aaronluebbert/ChessLink/pcb/Microcontroller Lab Summer 2026/ESP+Power_Only/ESP+Power_Only.kicad_pcb

## KiCad design pcb/Microcontroller Lab Summer 2026/ESP+Power_Only/ESP+Power_Only.kicad_pcb (2026-08-12)

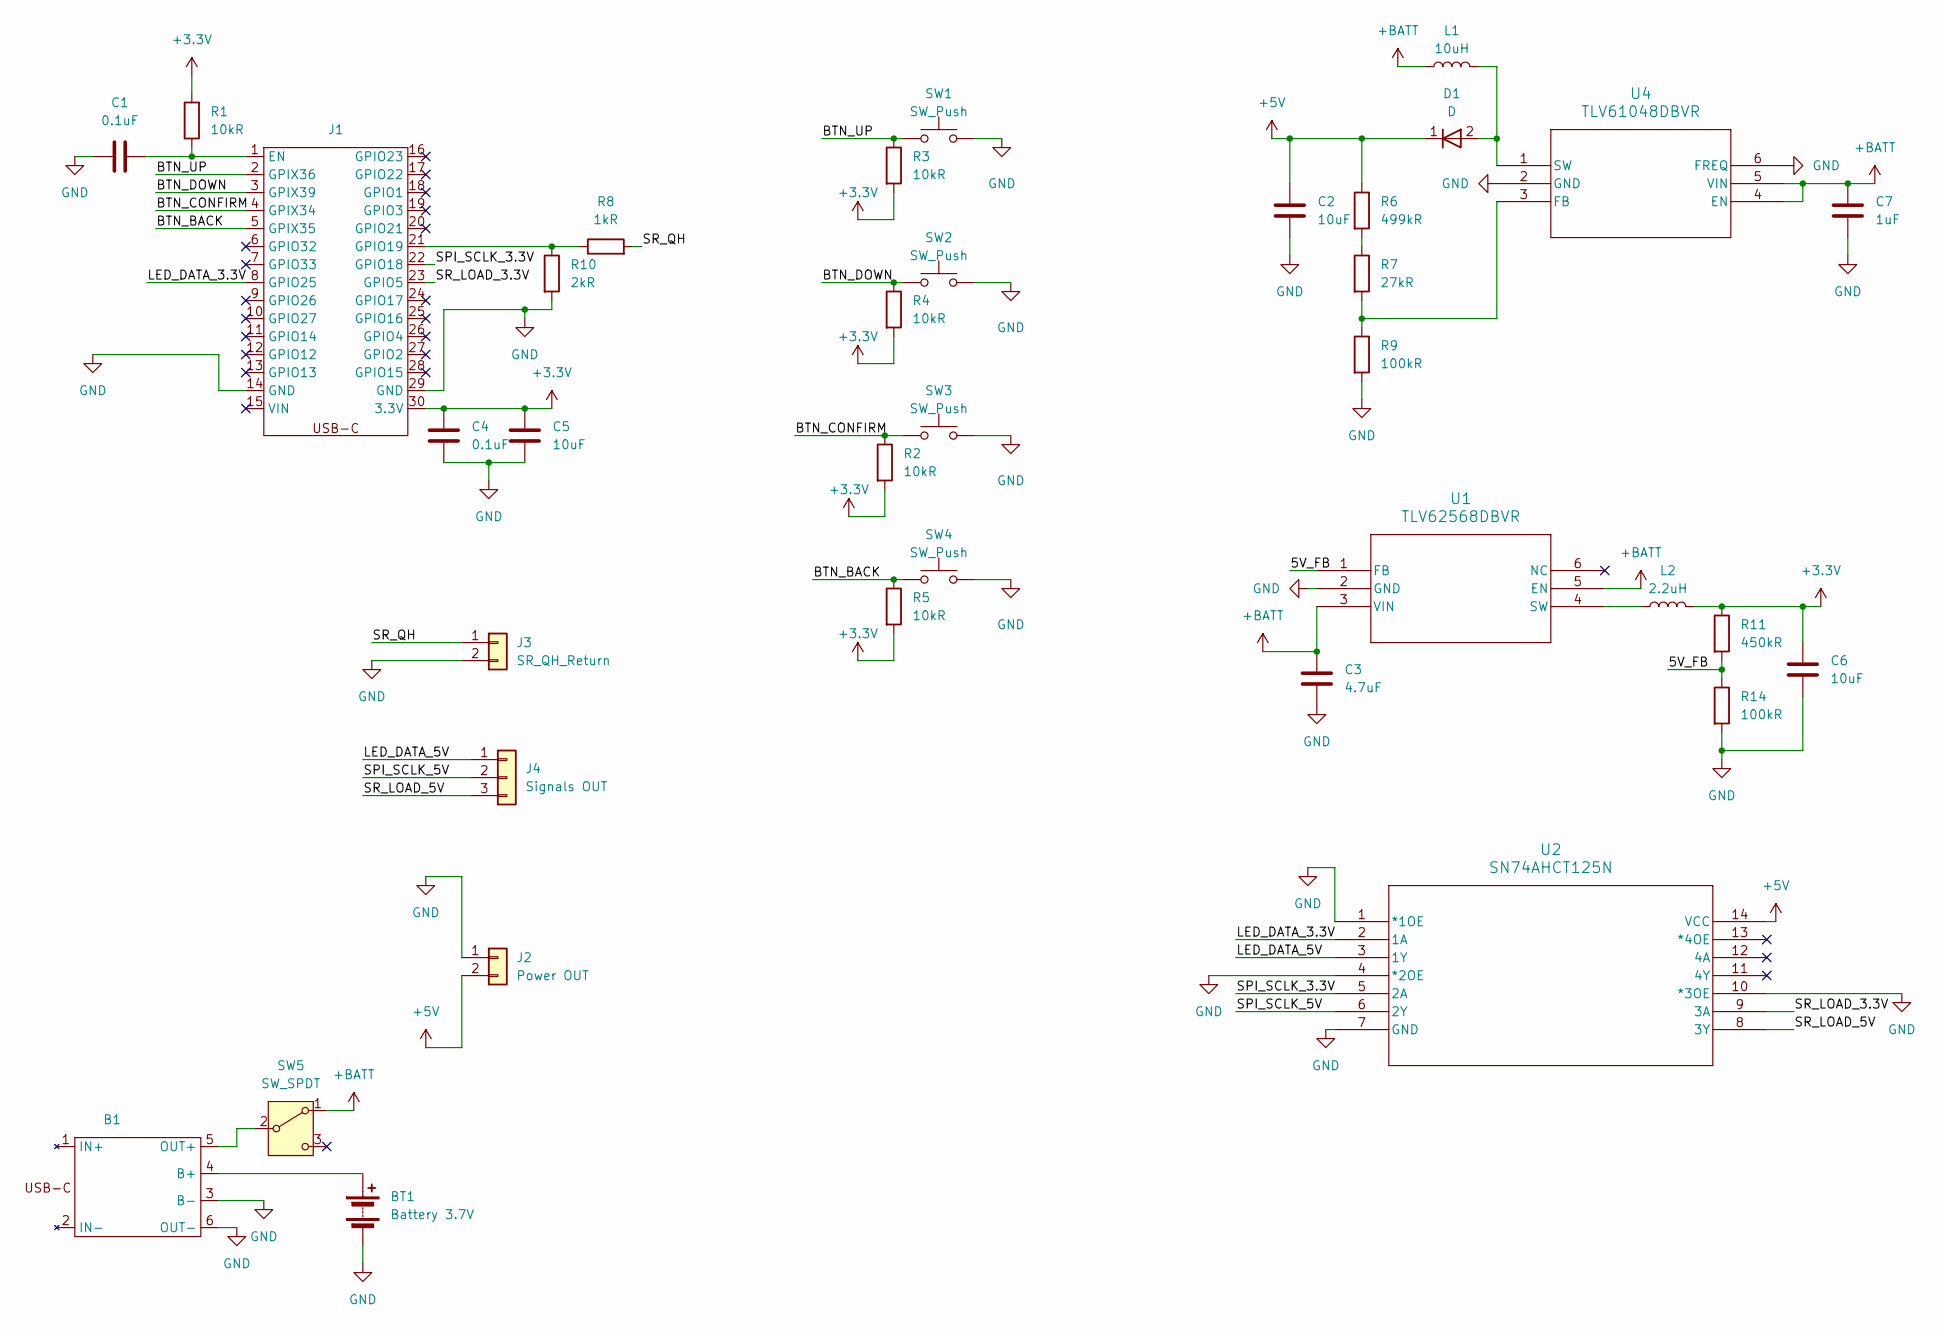
[picture p1: schematic ESP+Power_Only.kicad_sch]

Parts:
B1: Battery_Charger_Board
BT1: Battery 3.7V
C1, C4: 0.1uF; C_0402_1005Metric; LCSC C1525
C2, C5, C6: 10uF; C_0603_1608Metric; LCSC C1691
C3: 4.7uF; C_0603_1608Metric; LCSC C1705
C7: 1uF; C_0603_1608Metric; LCSC C1592
D1: D; ChessLink_Schottky_Diode; LCSC C8678
J1: ESP
J2: Power OUT; Pin header spacing
J3: SR_QH_Return; PinHeader_1x02_P2.54mm_Vertical
J4: Signals OUT; PinHeader_1x03_P2.54mm_Vertical
L1: 10uH; ChessLink_10uH_Inductor; LCSC C181721
L2: 2.2uH; ChessLink_2.2uH_Inductor; LCSC C133191
R1, R2, R3, R4, R5: 10kR; R_1206_3216Metric; LCSC C17902
R6: 499kR; R_0402_1005Metric; LCSC C25793
R7: 27kR; R_1206_3216Metric; LCSC C1498
R8: 1kR; R_1206_3216Metric; LCSC C1469
R9, R14: 100kR; R_0603_1608Metric; LCSC C1996
R10: 2kR; R_0805_2012Metric; LCSC C1359
R11: 450kR; R_0402_1005Metric; LCSC C5159688
SW1, SW2, SW3, SW4: SW_Push; SW_TH_Tactile_Omron_B3F-100x
SW5: SW_SPDT; Switch
U1: TLV62568DBVR; LCSC C163219
U2: SN74AHCT125N; DIP-14_W7.62mm_LongPads
U4: TLV61048DBVR; LCSC C2861467

Connections:
+3.3V: C4.2, C5.2, C6.1, J1.30 (3.3V), L2.2, R1.2, R2.2, R3.2, R4.2, R5.2, R11.1
+5V: C2.1, D1.1 (K), J2.2, R6.1, U2.14 (VCC)
+BATT: C3.1, C7.1, L1.1, SW5.1 (A), U1.3 (VIN), U1.5 (EN), U4.4 (EN), U4.5 (VIN)
/5V_FB: R11.2, R14.1, U1.1 (FB)
/BTN_BACK: J1.5 (GPIX35), R5.1, SW4.1
/BTN_CONFIRM: J1.4 (GPIX34), R2.1, SW3.1
/BTN_DOWN: J1.3 (GPIX39), R4.1, SW2.1
/BTN_UP: J1.2 (GPIX36), R3.1, SW1.1
/LED_DATA_3.3V: J1.8 (GPIO25), U2.2 (1A)
/LED_DATA_5V: J4.1, U2.3 (1Y)
/SPI_SCLK_3.3V: J1.22 (GPIO18), U2.5 (2A)
/SPI_SCLK_5V: J4.2, U2.6 (2Y)
/SR_LOAD_3.3V: J1.23 (GPIO5), U2.9 (3A)
/SR_LOAD_5V: J4.3, U2.8 (3Y)
/SR_QH: J3.1, R8.2
GND: B1.3 (B-), B1.6 (OUT-), BT1.2 (-), C1.1, C2.2, C3.2, C4.1, C5.1, C6.2, C7.2, J1.14 (GND), J1.29 (GND), J2.1, J3.2, R9.2, R10.2, R14.2, SW1.2, SW2.2, SW3.2, SW4.2, U1.2 (GND), U2.1 (*1OE), U2.4 (*2OE), U2.7 (GND), U2.10 (*3OE), U4.2 (GND), U4.6 (FREQ)
unnamed: B1.4 (B+), BT1.1 (+)
unnamed: B1.5 (OUT+), SW5.2 (B)
unnamed: D1.2 (A), L1.2, U4.1 (SW)
unnamed: C1.2, J1.1 (EN), R1.1
unnamed: J1.21 (GPIO19), R8.1, R10.1
unnamed: R6.2, R7.1
unnamed: L2.1, U1.4 (SW)
unnamed: R7.2, R9.1, U4.3 (FB)

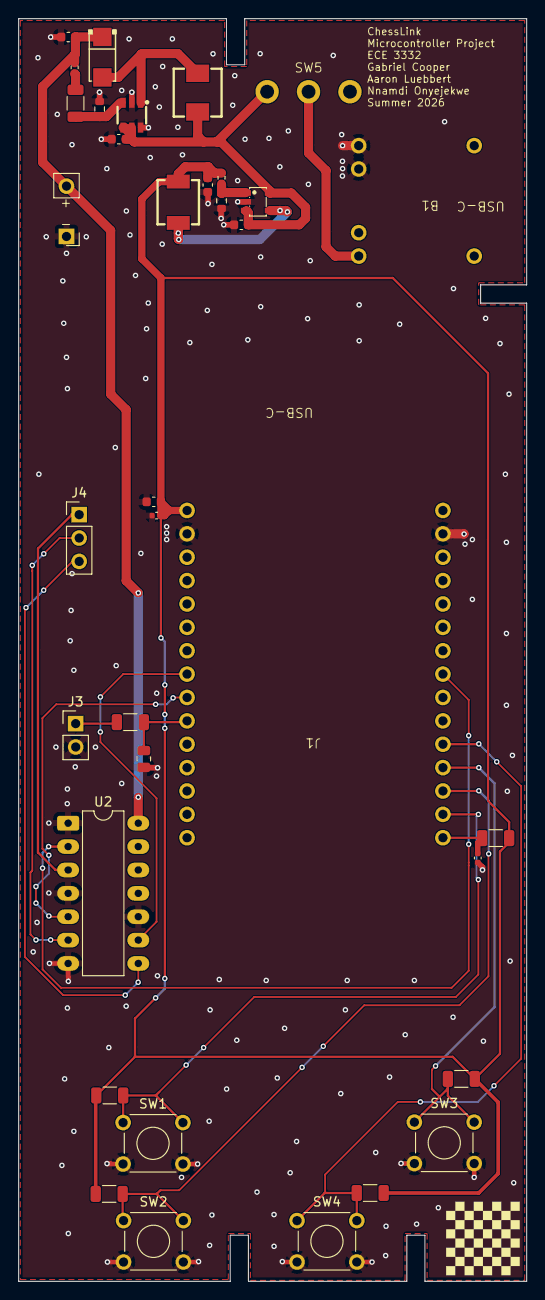
[picture p2: board ESP+Power_Only.kicad_pcb from above]

Board: 2 copper layers, 55.2 x 137.2 mm, 35 parts (0 on the bottom side), 23 nets.
