aaronluebbert/ChessLink/pcb/Microcontroller Lab Summer 2026/Sensors+LEDs/Sensors+LEDs.kicad_pcb

## KiCad design pcb/Microcontroller Lab Summer 2026/Sensors+LEDs/Sensors+LEDs.kicad_pcb (2026-08-12)

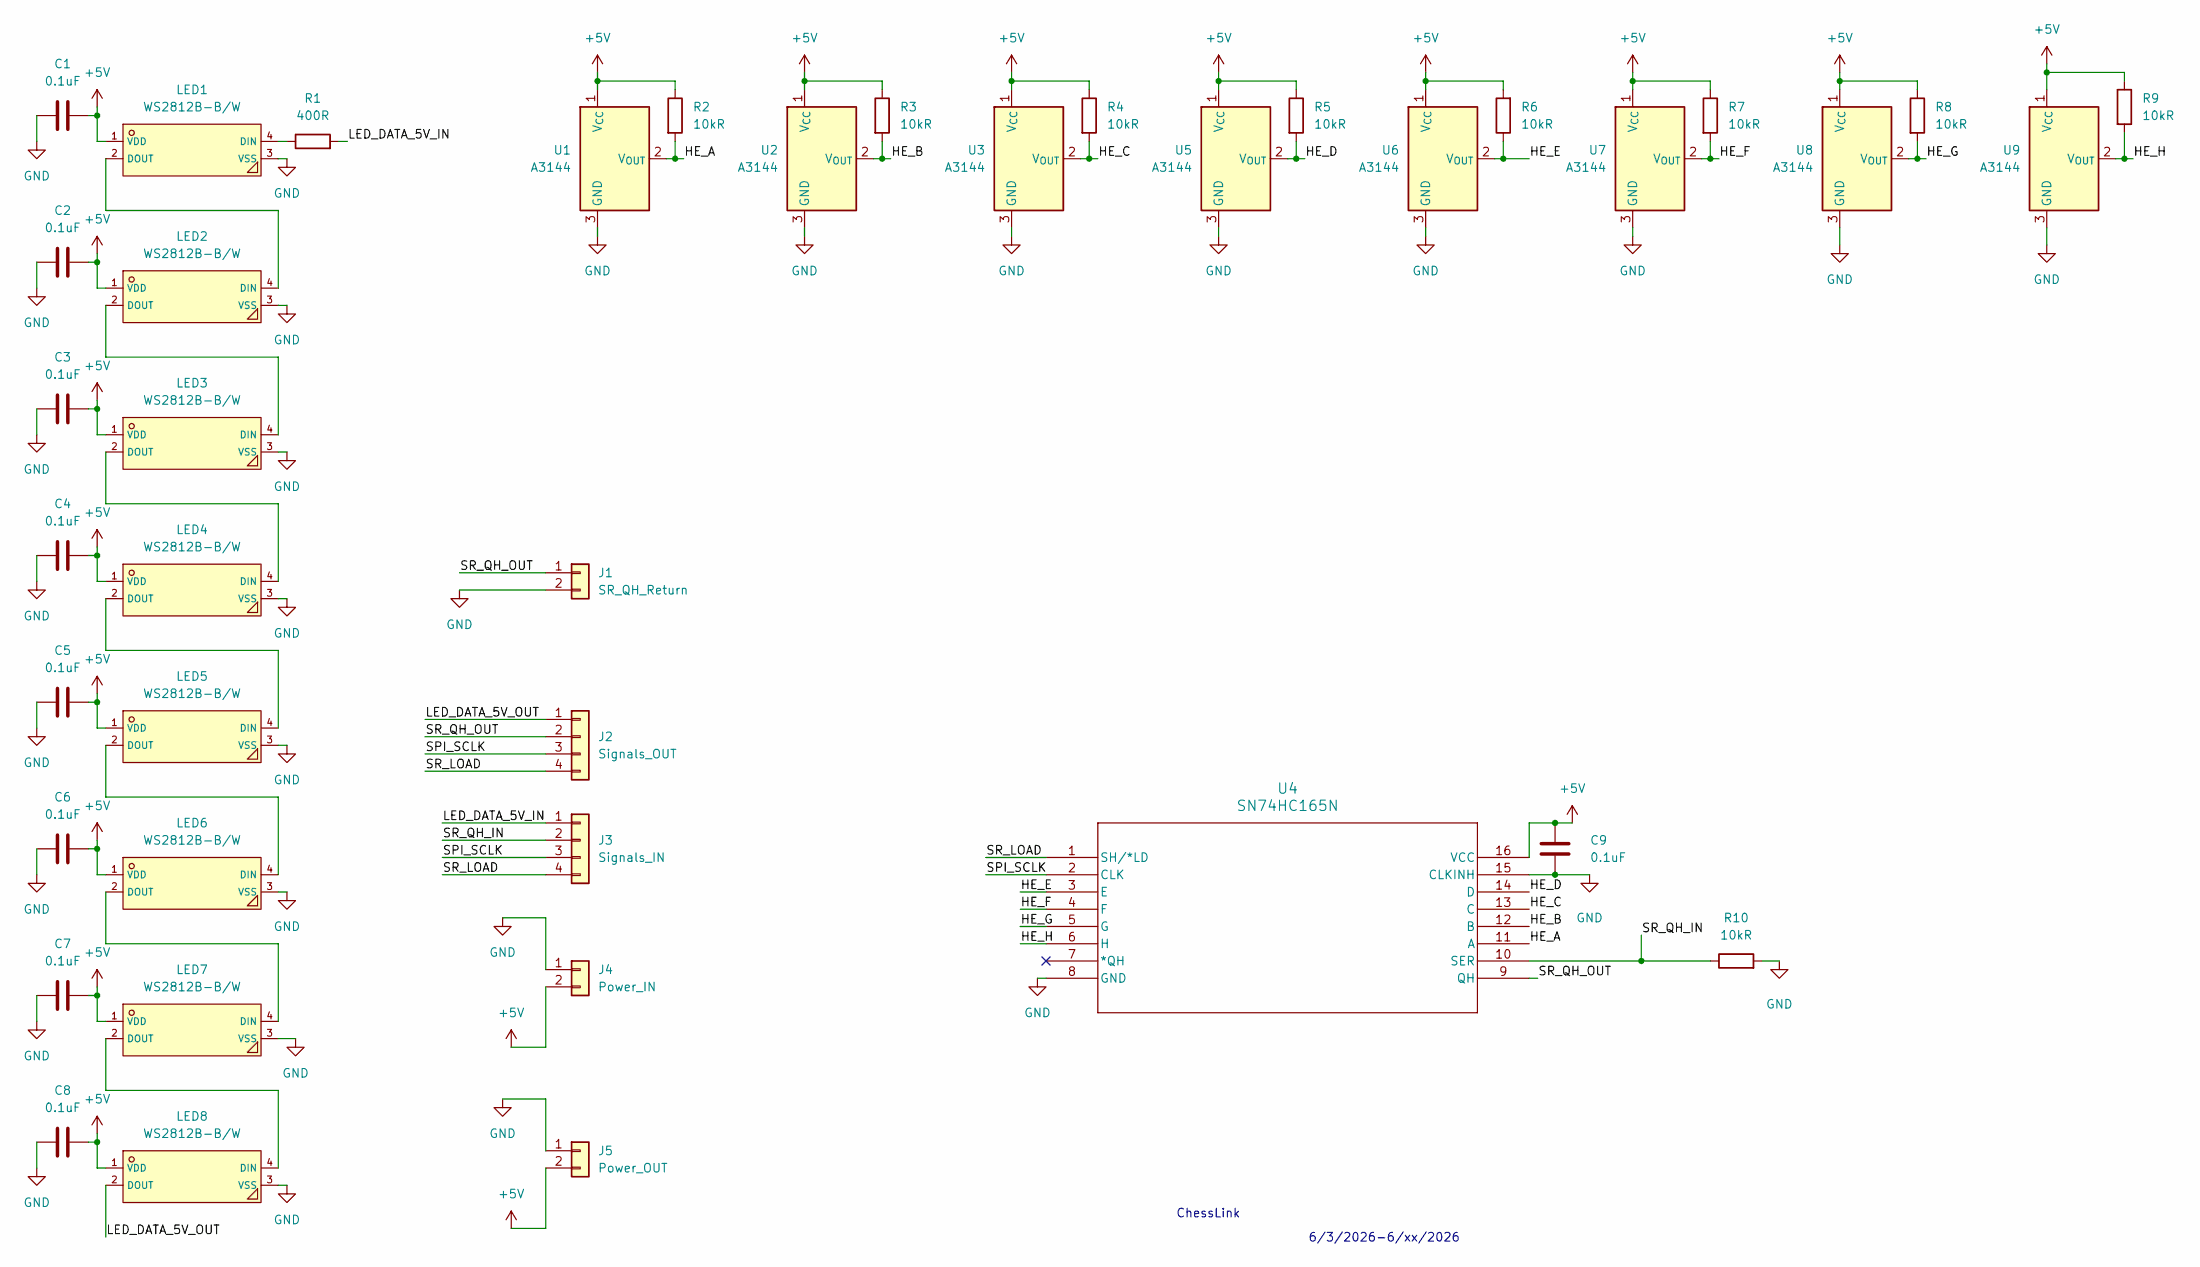
[picture p3: schematic Sensors+LEDs.kicad_sch]

Parts:
C1, C2, C3, C4, C5, C6, C7, C8, C9: 0.1uF; C_0402_1005Metric; LCSC C1525
J1: SR_QH_Return; PinHeader_1x02_P2.54mm_Vertical
J2: Signals_OUT; PinHeader_1x04_P2.54mm_Vertical
J3: Signals_IN; PinHeader_1x04_P2.54mm_Vertical
J4: Power_IN; Pin header spacing
J5: Power_OUT; Pin header spacing
LED1, LED2, LED3, LED4, LED5, LED6, LED7, LED8: WS2812B-B/W; WS2812B-B_W; LCSC C2761795
R1: 400R; R_1206_3216Metric; LCSC C706413
R2, R3, R4, R5, R6, R7, R8, R9, R10: 10kR; R_1206_3216Metric; LCSC C17902
U1, U2, U3, U5, U6, U7, U8, U9: A3144
U4: SN74HC165N; DIP-16_W7.62mm_LongPads

Connections:
+5V: C1.2, C2.2, C3.2, C4.2, C5.2, C6.2, C7.2, C8.2, C9.1, J4.2, J5.2, LED1.1 (VDD), LED2.1 (VDD), LED3.1 (VDD), LED4.1 (VDD), LED5.1 (VDD), LED6.1 (VDD), LED7.1 (VDD), LED8.1 (VDD), R2.1, R3.1, R4.1, R5.1, R6.2, R7.1, R8.1, R9.1, U1.1 (V_{CC}), U2.1 (V_{CC}), U3.1 (V_{CC}), U4.16 (VCC), U5.1 (V_{CC}), U6.1 (V_{CC}), U7.1 (V_{CC}), U8.1 (V_{CC}), U9.1 (V_{CC})
/HE_A: R2.2, U1.2 (V_{OUT}), U4.11 (A)
/HE_B: R3.2, U2.2 (V_{OUT}), U4.12 (B)
/HE_C: R4.2, U3.2 (V_{OUT}), U4.13 (C)
/HE_D: R5.2, U4.14 (D), U5.2 (V_{OUT})
/HE_E: R6.1, U4.3 (E), U6.2 (V_{OUT})
/HE_F: R7.2, U4.4 (F), U7.2 (V_{OUT})
/HE_G: R8.2, U4.5 (G), U8.2 (V_{OUT})
/HE_H: R9.2, U4.6 (H), U9.2 (V_{OUT})
/LED_DATA_5V_IN: J3.1, R1.2
/LED_DATA_5V_OUT: J2.1, LED8.2 (DOUT)
/SPI_SCLK: J2.3, J3.3, U4.2 (CLK)
/SR_LOAD: J2.4, J3.4, U4.1 (SH/*LD)
/SR_QH_IN: J3.2, R10.1, U4.10 (SER)
/SR_QH_OUT: J1.1, J2.2, U4.9 (QH)
GND: C1.1, C2.1, C3.1, C4.1, C5.1, C6.1, C7.1, C8.1, C9.2, J1.2, J4.1, J5.1, LED1.3 (VSS), LED2.3 (VSS), LED3.3 (VSS), LED4.3 (VSS), LED5.3 (VSS), LED6.3 (VSS), LED7.3 (VSS), LED8.3 (VSS), R10.2, U1.3 (GND), U2.3 (GND), U3.3 (GND), U4.8 (GND), U4.15 (CLKINH), U5.3 (GND), U6.3 (GND), U7.3 (GND), U8.3 (GND), U9.3 (GND)
unnamed: LED1.4 (DIN), R1.1
unnamed: LED1.2 (DOUT), LED2.4 (DIN)
unnamed: LED2.2 (DOUT), LED3.4 (DIN)
unnamed: LED3.2 (DOUT), LED4.4 (DIN)
unnamed: LED4.2 (DOUT), LED5.4 (DIN)
unnamed: LED5.2 (DOUT), LED6.4 (DIN)
unnamed: LED6.2 (DOUT), LED7.4 (DIN)
unnamed: LED7.2 (DOUT), LED8.4 (DIN)

Notes on the sheet:
ChessLink
6/3/2026-6/xx/2026

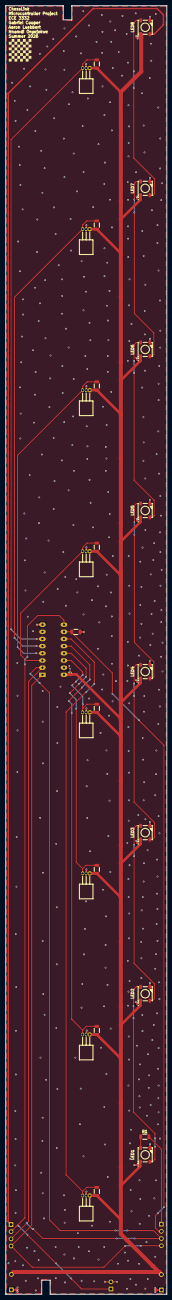
[picture p4: board Sensors+LEDs.kicad_pcb from above]

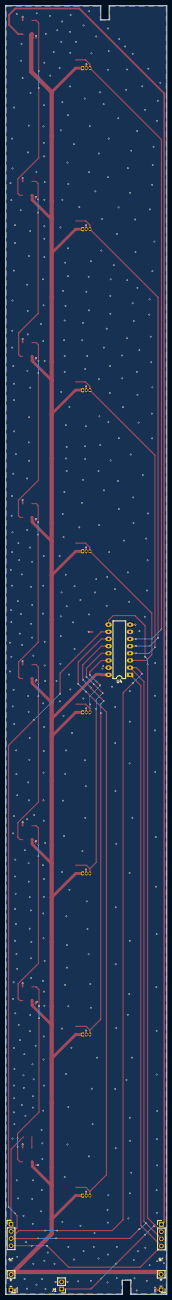
[picture p5: board Sensors+LEDs.kicad_pcb from below]

Board: 2 copper layers, 57.1 x 456.8 mm, 41 parts (6 on the bottom side), 24 nets.
