aaronluebbert/ChessLink/(commit log)

2026-06-28 updated rtos logic to account for pcb ssetup decisions
2026-06-28 pcb files added. added .gitignore for kicad backup files and lock files
    [ESP+Power_Only.kicad_pcb, ESP+Power_Only.kicad_sch, Microcontroller Lab Summer 2026.kicad_pcb, Microcontroller Lab Summer 2026.kicad_sch, Sensors+LEDs.kicad_pcb, Sensors+LEDs.kicad_sch, bom.csv, designators.csv]
2026-07-01 fixed PCB footprints, pending final review before order
    [ESP+Power_Only.kicad_pcb, ESP+Power_Only.kicad_sch, Sensors+LEDs.kicad_pcb, Sensors+LEDs.kicad_sch, bom.csv, positions.csv]
2026-07-09 fixed thermal relief areas, double checked new footprints, ready to order, need to generate gerber files, bom, placement csv and such
    [ESP+Power_Only.kicad_pcb, Sensors+LEDs.kicad_pcb]
2026-07-09 generated production files and ordered
    [positions.csv]
2026-08-07 various bug fixes and improvements
    [chesslink.h, task_display.cpp, task_game.cpp]
2026-08-11 fixed detection pcb dip-16 footprint. fixed esp pcb charger board polarity, minor trace adjustments, level shifting for spi sclk and shift register mode signals. fixed charger board polarity footprin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
    [ESP+Power_Only.kicad_pcb, ESP+Power_Only.kicad_sch, Sensors+LEDs.kicad_pcb, Sensors+LEDs.kicad_sch]
2026-08-12 fixed charger board footprint (i think)
